DaveGuenther/Plant-Light-Logger/(list of files, drawings)

Other design files:
docs/Arduino Pro Mini SD-TFT Hookup.fzz
docs/Complete Circuit.fzz
