DaveGuenther/Plant-Light-Logger/(commit log)

2026-06-15 Lots of new test sketches. Completed Fritzing schematic. Ready to protoboard
    [Arduino Pro Mini SD-TFT Hookup.fzz, Complete Circuit.fzz]
2026-07-05 Updated Input Managerpleted circuit. Ready to start building calibrator
    [Complete Circuit.fzz]
2026-07-15 Created calibration.ino and updated SD card interfaces to use SdFAT so that it doesn't conflict with the AS7341
    [Complete Circuit.fzz]
2026-11-01 Added TimeManager class and cketch to keep track of the clock and cycle hours/days, etc
2026-11-01 Added DLI_Logger Headless skjetch and settings manager.
    Testing it
    Copy SettingsManager.h and DataManager.h from lib/ into the sketch folder (already done).
    Upload the sketch and open the Serial Monitor at 115200 baud with Newline line endings. It should say SD OK and list one location, DEFAULT_LOC, with the 60-minute interval.
    Try the commands:
    a Office, then a Friend House, then l. Both should appear.
    a Office again should give DUPLICATE, and a bad!name should give INVALID NAME.
    u 1 makes Office active. i 15 sets the interval.
    r 0 removes DEFAULT_LOC, and the active location should still be Office.
    Check that settings survive a reset: press the Mega's reset button and send l. The locations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
    [DLI_Logger.ino, DataManager.h, DataManagerTest.ino, SettingsManager.h, SettingsManagerTest.ino, TimeManager.h]
